LTU-RAI/mav_led_driver/(commit log)

2019-03-24 Design + layout
    [mav_led_driver.kicad_pcb, mav_led_driver.sch]
2019-03-27 Moved to castellated pads
    [mav_led_driver.kicad_pcb, mav_led_driver.sch]
2019-03-27 Improved vias
    [mav_led_driver.kicad_pcb]
2019-03-28 Better GND
    [mav_led_driver.kicad_pcb]
2019-04-16 Improved placement and design after mounting first version
    [mav_led_driver.kicad_pcb]
